PepVentura/Aut-mata-Halloween-/README.md

# Autómata de Halloween 🎃

Caja con tres figuras de Halloween (fantasma, momia y parca de una guirnalda LED) que bailan cuando alguien pasa por delante. Un motor paso a paso mueve un eje con tres excéntricas desfasadas 120°: cada figura sube, baja y cabecea a su ritmo.

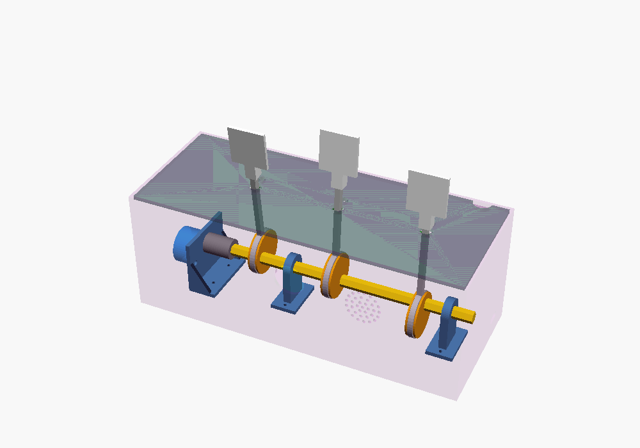
[picture p1: docs/montaje.png]
Montaje


## Cómo funciona

- **Motor:** 28BYJ-48 (5 V) con driver ULN2003, a unos 10 rpm.
- **Mecanismo:** eje hexagonal de 8 mm con tres excéntricas iguales (discos descentrados 8 mm); al montarlas se giran dos caras del hexágono (120°) entre sí. Cada biela abraza su excéntrica con un collar, pivota en un agujero de la tapa y lleva arriba una paleta donde se pega la figura. Como el eje queda dentro de la excéntrica, el mecanismo da vueltas completas en los dos sentidos sin que la biela toque el eje.
- **Disparo:** sensor PIR HC-SR501 en la pared frontal. Al detectar a alguien, las figuras bailan 20 s con tramos aleatorios y algún cambio de sentido.
- **Control:** Arduino (Nano/Uno).
- **Sonido:** módulo grabador de voz con un efecto grabado que suena al empezar cada baile, por un altavoz de 8 Ω 2 W tras una rejilla en la pared frontal.
- **Alimentación:** 5 V por un conector USB-C de panel en el lateral.

## Estructura

| Carpeta | Contenido |
|---|---|
| `cad/` | Diseño paramétrico en OpenSCAD (`MODO` elige montaje, piezas, caja, tapa…) |
| `stl/` | Piezas exportadas listas para laminar |
| `firmware/` | Sketch definitivo (`automata_halloween`) y sketch de prueba de componentes (`prueba_componentes`) |
| `docs/` | Manuales, esquema de conexiones, vistas del montaje y plantilla 2D de la tapa |

## Piezas a imprimir

| STL | Cantidad | Notas |
|---|---|---|
| `eje.stl` | 1 | 200 mm, tumbado sobre una cara plana |
| `excentrica.stl` | 3 | Reborde contra la cama |
| `arandela.stl` | 3 | Plana (segundo reborde de cada excéntrica) |
| `biela.stl` | 3 | Plana (collar + brazo) |
| `paleta.stl` | 3 | Cara de pegar la figura contra la cama |
| `acople.stl` | 1 | De pie |
| `soporte.stl` | 2 | De pie, sin soportes |
| `soporte_motor.stl` | 1 | De pie, sin soportes |
| `caja.stl` | 1 | Boca arriba, 251 × 101 × 95 mm (cabe en la Kobra X) |
| `tapa.stl` | 1 | Plana |

## Material

- Motor 28BYJ-48 + placa ULN2003
- Sensor PIR HC-SR501
- Arduino Nano o Uno
- Conector USB-C de panel con cables
- Módulo grabador de voz (30/120 s), altavoz 8 Ω 2 W (30 mm) y un diodo 1N4007 o 1N4148
- Tornillería: 2 × M3/M4 (motor), 6 × M2 x 6 avellanados de rosca chapa (arandela a excéntrica), 6 × M3x8 avellanados de rosca chapa (soportes desde debajo de la caja), 2 × M2 de rosca chapa (PIR), 10 × rosca chapa M3/2,9 x 10 y 2 × M2 x 8 de rosca chapa (placas electrónicas)
- Transistor NPN (2N2222/BC547), resistencias de 1 kΩ y 10–22 Ω, condensador 470 µF / 10 V y placa perforada para el reparto de 5 V/GND
- Las figuras se alimentan del pin 3,3 V del Uno (consumo < 100 mA, sin pilas)

## Conexiones

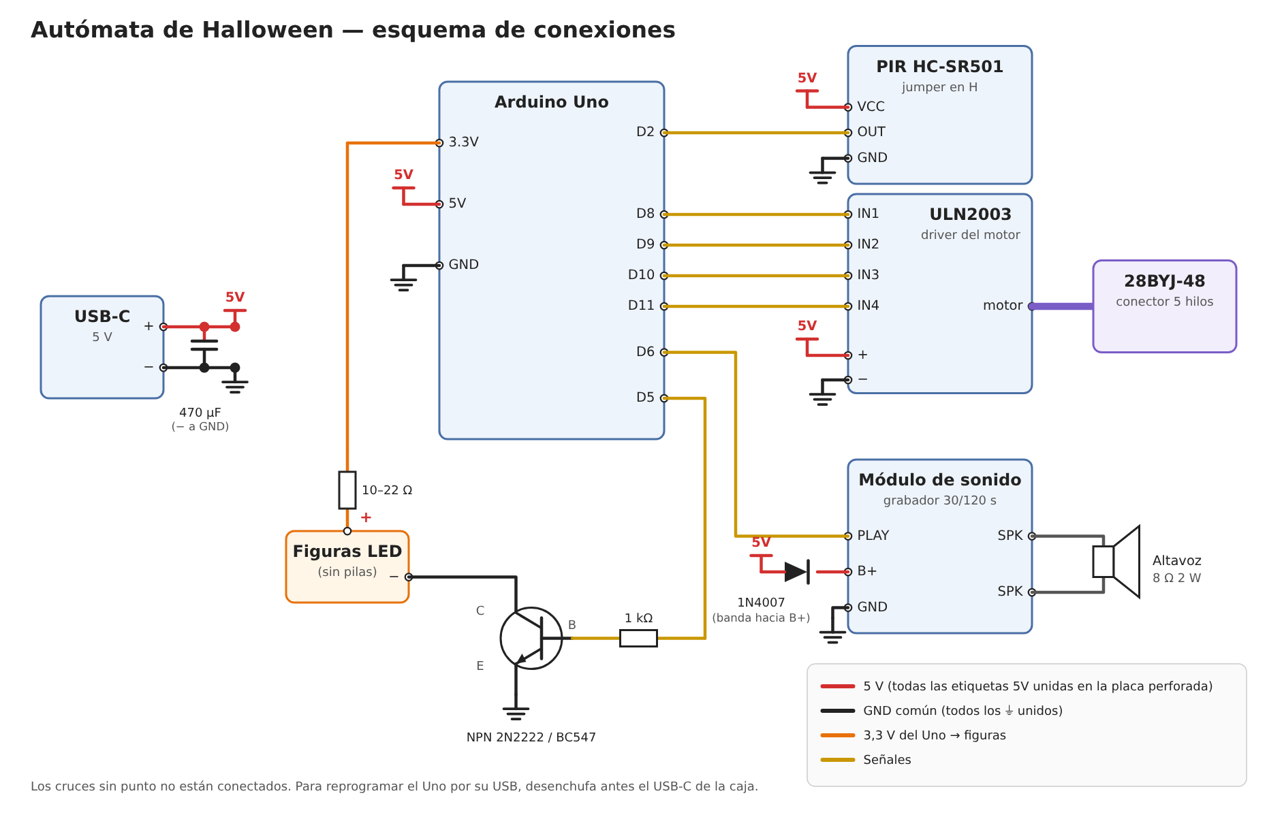
[picture p2: docs/esquema.png]
Esquema de conexiones


Manuales: **[Arduino Uno](docs/manual_arduino.md)** (pines, alimentación, programación, pruebas por partes, configuración y problemas) y **[módulo de sonido](docs/manual_modulo_sonido.md)**.

| Componente | Pin | Arduino |
|---|---|---|
| HC-SR501 | VCC / GND / OUT | 5V / GND / D2 |
| ULN2003 | IN1–IN4 | D8–D11 |
| ULN2003 | + / − | 5 V y GND del USB-C |
| Módulo de sonido | B+ / GND | 5V **a través de un diodo** (~4,3 V) / GND |
| Módulo de sonido | PE (reproducción por pulso) | D6 |
| Módulo de sonido | SPK | Altavoz 8 Ω |
| Figuras LED | Base del NPN vía 1 kΩ | D5 |
| Figuras LED | + (vía 10–22 Ω) / − al colector del NPN | 3.3V / emisor del NPN a GND |
| Uno | 5V / GND | 5 V y GND del USB-C (no usar VIN ni el jack) |
| Condensador 470 µF | + / − | 5 V / GND, junto a la entrada USB-C |

Ajustes del HC-SR501: jumper en **H** (redisparo) y potenciómetro de tiempo al mínimo; la duración del baile la decide el código. Al encender, el PIR necesita ~1 minuto para estabilizarse.

## Avisos

- **USB-C:** muchos conectores de dos cables no llevan las resistencias de 5,1 kΩ en CC. Sin ellas, un cargador USB-C a USB-C no da corriente; usa un cable USB-A a USB-C.
- **Hueco del USB-C:** hecho para el cuerpo del conector (12 × 5 mm medidos, con 0,4 mm de holgura): el cuerpo atraviesa la pared desde fuera, el frontal más ancho hace de tope y las pestañas enganchan por dentro en la pared rebajada. Antes de la caja imprime `stl/prueba_usb.stl` (un trozo de pared de 2 minutos) y, si no encaja, ajusta `usb_w`, `usb_h` y `usb_pared`.
- **Altavoz:** de 30 mm (`alt_d`). Se coloca con el cono hacia la rejilla dentro del aro y se fija con unos puntos de termocola.
- **Placas electrónicas:** van de pie en la pared trasera sobre columnas de 6 mm (el Uno no cabe tumbado). Las medidas del Uno son las oficiales; las del ULN2003 (agujeros a 27 × 30 mm) y el módulo de sonido (placa 28 × 30, agujeros a 25 × 5 mm: el izquierdo abajo y el derecho 5 mm más alto, tornillos M2) están medidas; la placa del transistor es provisional: mide la posición de sus agujeros y ajusta la lista `placas` antes de imprimir la caja.
- **Lente del PIR:** ajusta `pir_sep` según el grosor de la base de la lente.
- **Motor parado:** el sketch apaga las bobinas al terminar cada baile para que no se caliente.

## Grabar el sonido

Consulta el **[manual del módulo de sonido](docs/manual_modulo_sonido.md)**: identificación de pads, conexionado, configuración, cómo grabar (con micrófono o por cable) y solución de problemas. En resumen: graba unos 20 s para que coincida con `DURACION_BAILE` y conecta D6 al pad **PE** (reproducción por pulso).

## Montaje

1. Atornilla el soporte del motor y los dos soportes del eje desde debajo de la caja.
2. Fija el motor al soporte y encaja el acople en su eje.
3. Mete el eje hexagonal por los soportes. Para cada figura, ensarta en este orden: excéntrica (reborde hacia el motor), biela con el collar alrededor del disco y arandela, con el mismo contorno que la excéntrica y el avellanado hacia fuera. Atornilla la arandela a la excéntrica con dos M2 x 6. Cada excéntrica va girada dos caras del hexágono (120°) respecto a la anterior. Cuando las bielas estén alineadas con los agujeros de la tapa, fija cada excéntrica al eje con una gota de cianoacrilato para que no se desplace. Un poco de vaselina o grasa de silicona en el disco reduce el ruido.
4. Comprueba girando el eje a mano que da vueltas completas sin enganches.
5. Pasa las bielas por los agujeros de la tapa, encaja las paletas y pega las figuras por detrás.
6. Baja los cables de la guirnalda por los agujeros pequeños, dejando un bucle flojo dentro.
7. Pega el altavoz en su aro de la pared frontal.
8. Atornilla el Arduino, el ULN2003, el módulo de sonido y la placa del transistor a sus columnas de la pared trasera, con los componentes hacia dentro. La pila de la guirnalda va con cinta de doble cara en el suelo, detrás del mecanismo.

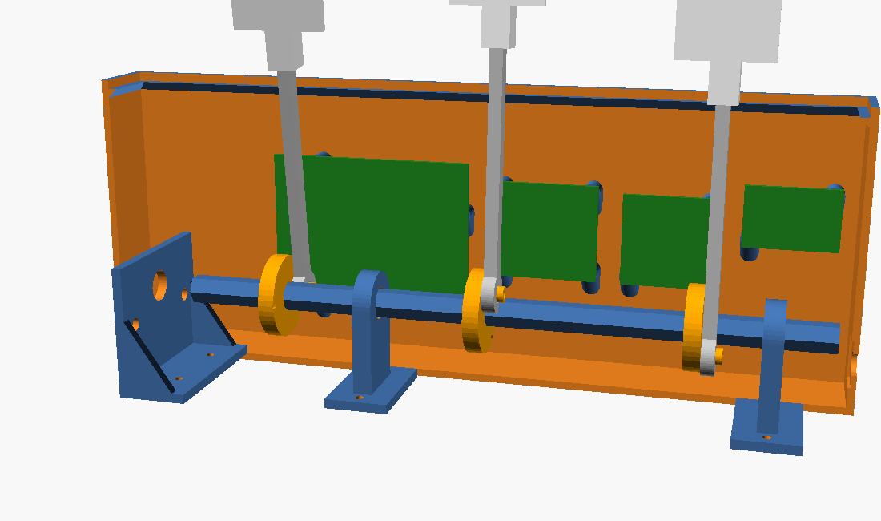
[picture p3: docs/interior.png]
Interior
