PepVentura/Aut-mata-Halloween-/docs/caja.png

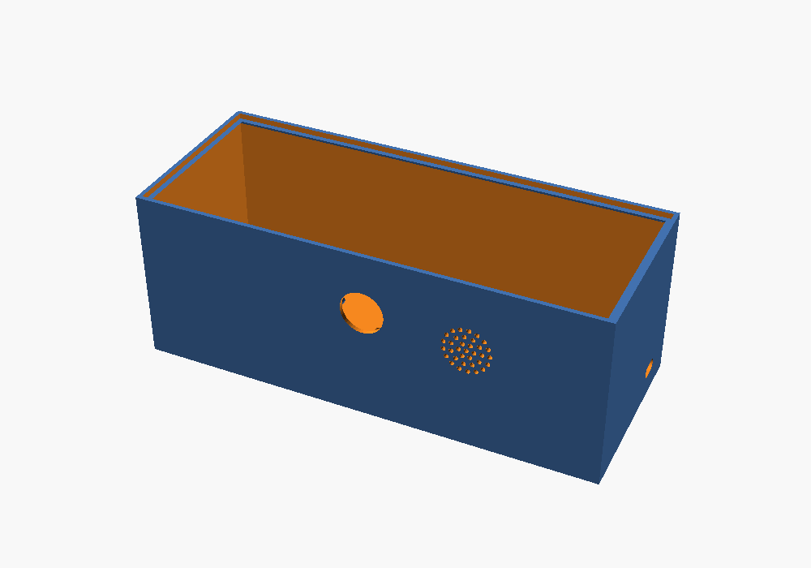
docs/caja.png
