PepVentura/Aut-mata-Halloween-/docs/frente.png

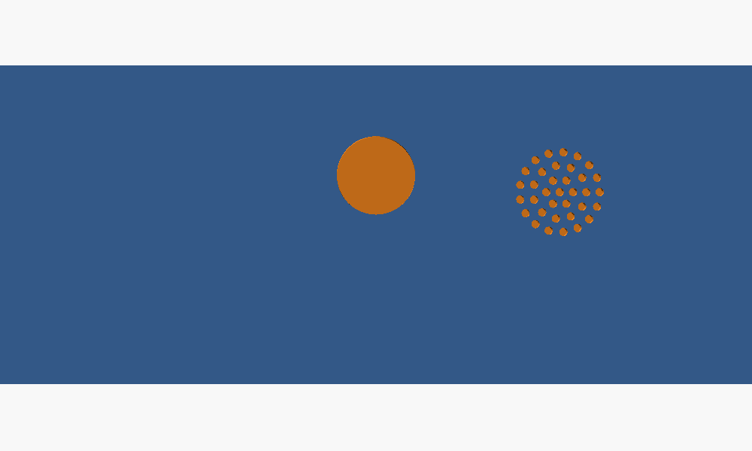
docs/frente.png
