PepVentura/Aut-mata-Halloween-/docs/imprimir.png

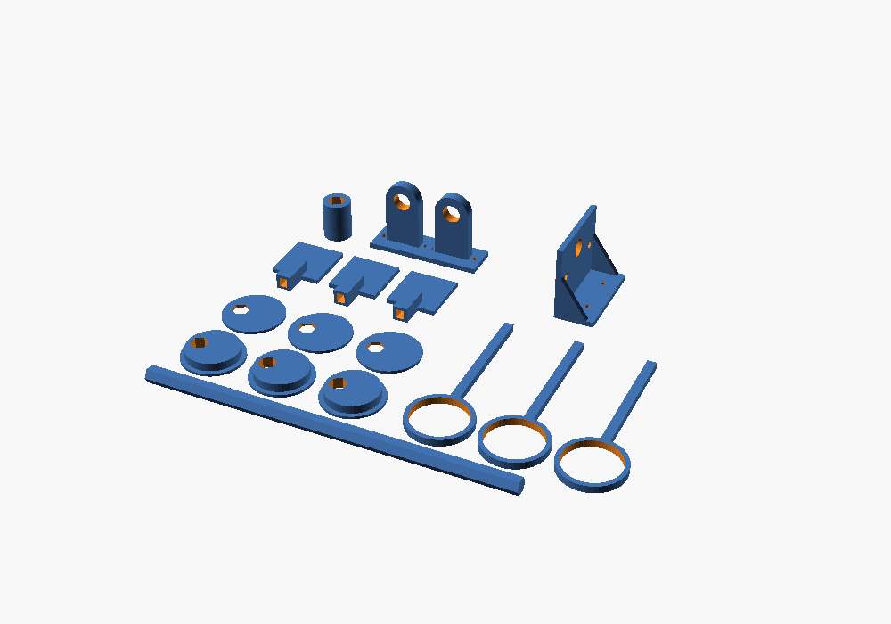
docs/imprimir.png
