PepVentura/Aut-mata-Halloween-/stl/arandela.stl

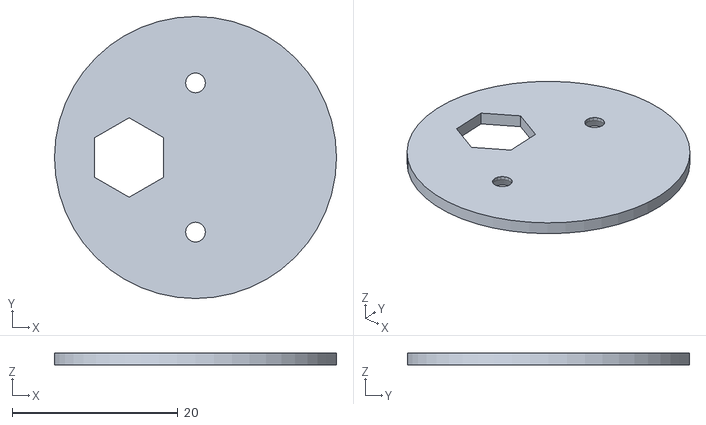
[picture p7: CAD file, 2026-10-29]
stl/arandela.stl
34.0 x 34.0 x 1.50
