PepVentura/Aut-mata-Halloween-/stl/excentrica.stl

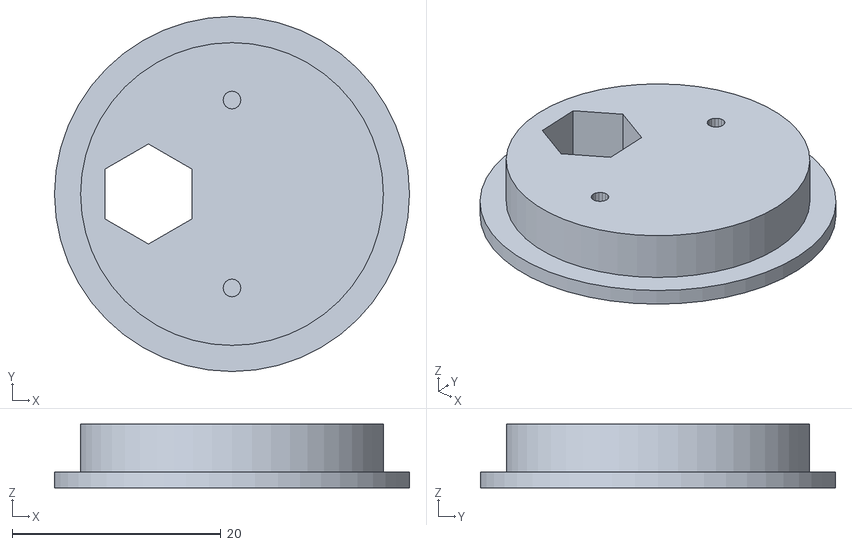
[picture p8: CAD file, 2026-10-29]
stl/excentrica.stl
34.0 x 34.0 x 6.10
