PepVentura/Aut-mata-Halloween-/stl/tapa.stl

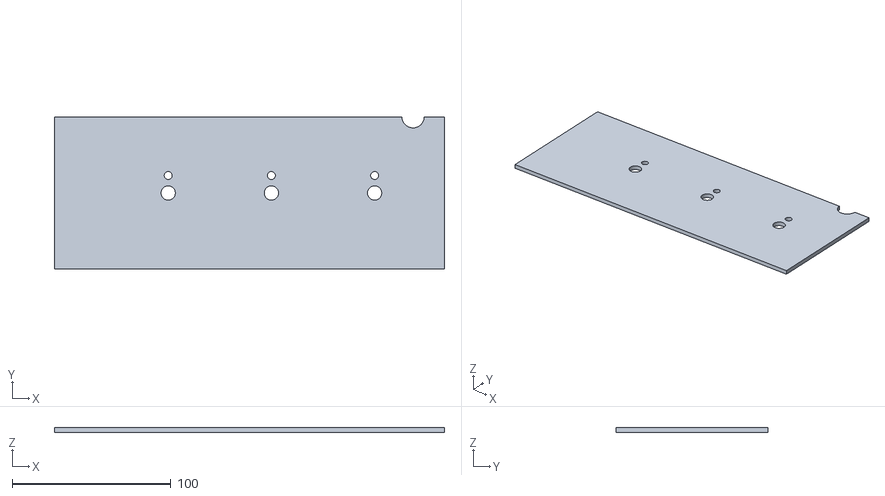
[picture p9: CAD file, 2026-10-28]
stl/tapa.stl
245.6 x 95.6 x 3.00
