PepVentura/Aut-mata-Halloween-/stl/biela.stl

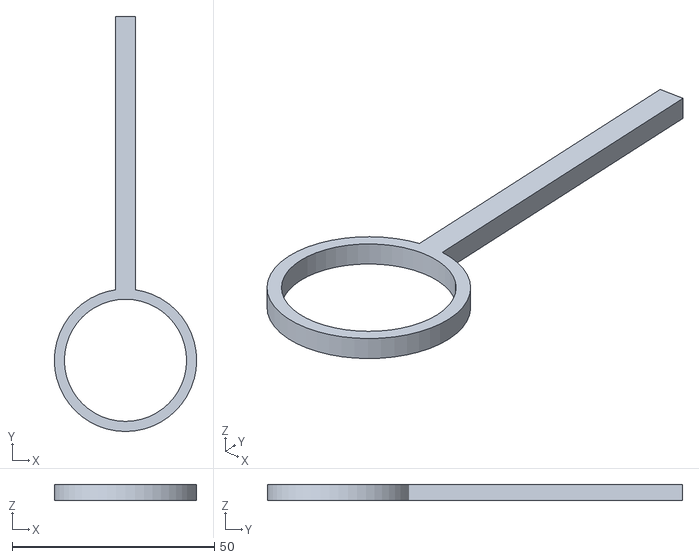
[picture p10: CAD file, 2026-10-28]
stl/biela.stl
35.2 x 102.6 x 4.00
