PepVentura/Aut-mata-Halloween-/stl/caja.stl

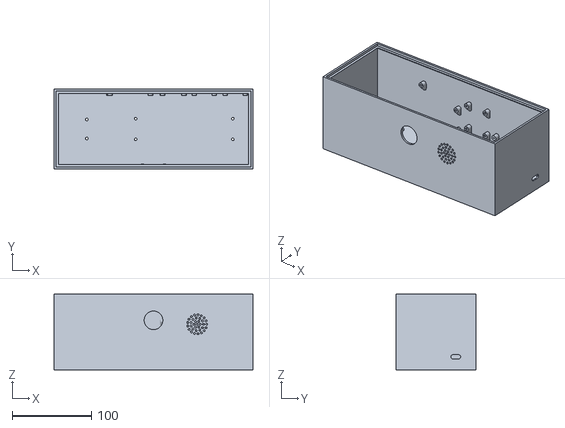
[picture p11: CAD file, 2026-10-27]
stl/caja.stl
250.8 x 100.8 x 95.4
