PepVentura/Aut-mata-Halloween-/stl/prueba_usb.stl

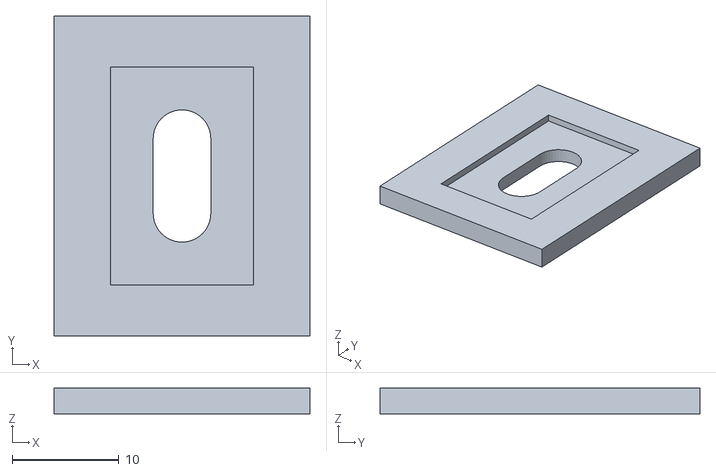
[picture p12: CAD file, 2026-10-27]
stl/prueba_usb.stl
24.0 x 30.0 x 2.40
