PepVentura/Aut-mata-Halloween-/stl/acople.stl

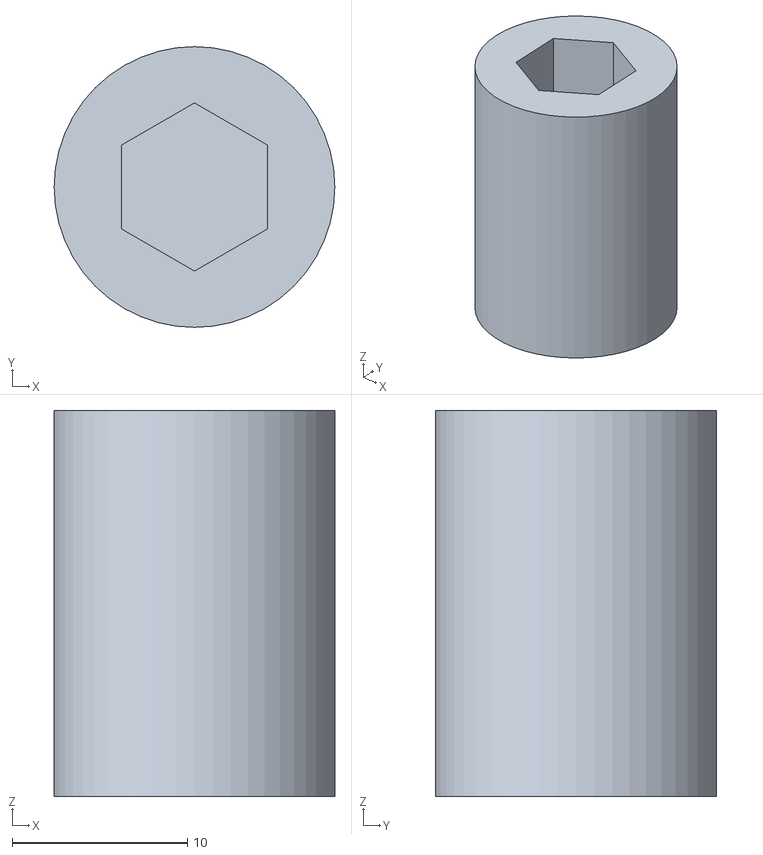
[picture p13: CAD file, 2026-10-26]
stl/acople.stl
16.0 x 16.0 x 22.0
