PepVentura/Aut-mata-Halloween-/stl/soporte_motor.stl

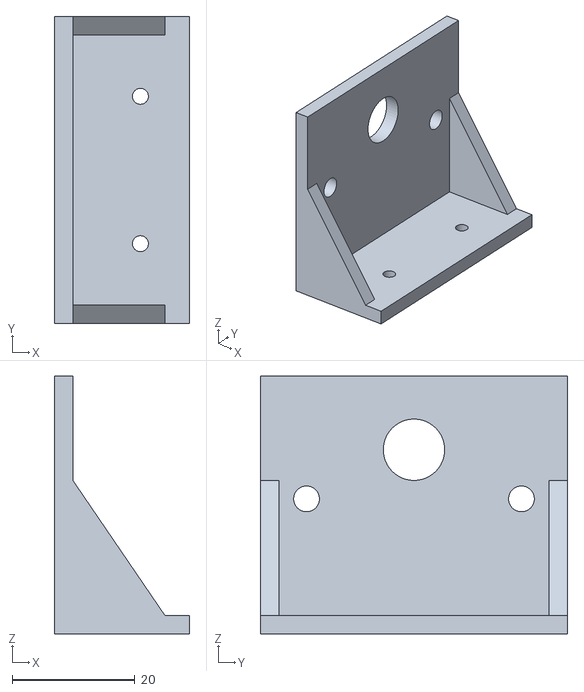
[picture p14: CAD file, 2026-10-26]
stl/soporte_motor.stl
22.0 x 50.0 x 42.0
