PepVentura/Aut-mata-Halloween-/stl/eje.stl

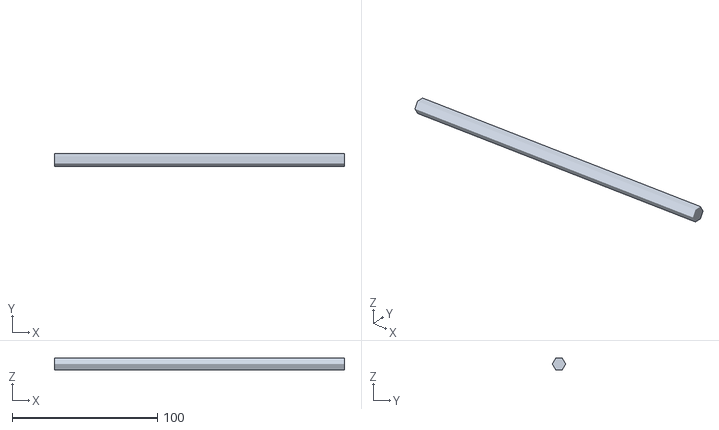
[picture p15: CAD file, 2026-10-26]
stl/eje.stl
200.0 x 9.24 x 8.00
