PepVentura/Aut-mata-Halloween-/stl/paleta.stl

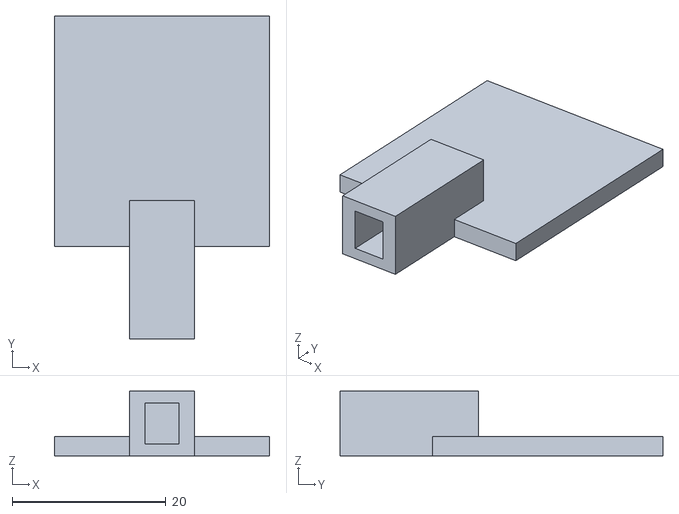
[picture p16: CAD file, 2026-10-26]
stl/paleta.stl
28.0 x 42.0 x 8.40
