PepVentura/Aut-mata-Halloween-/stl/soporte.stl

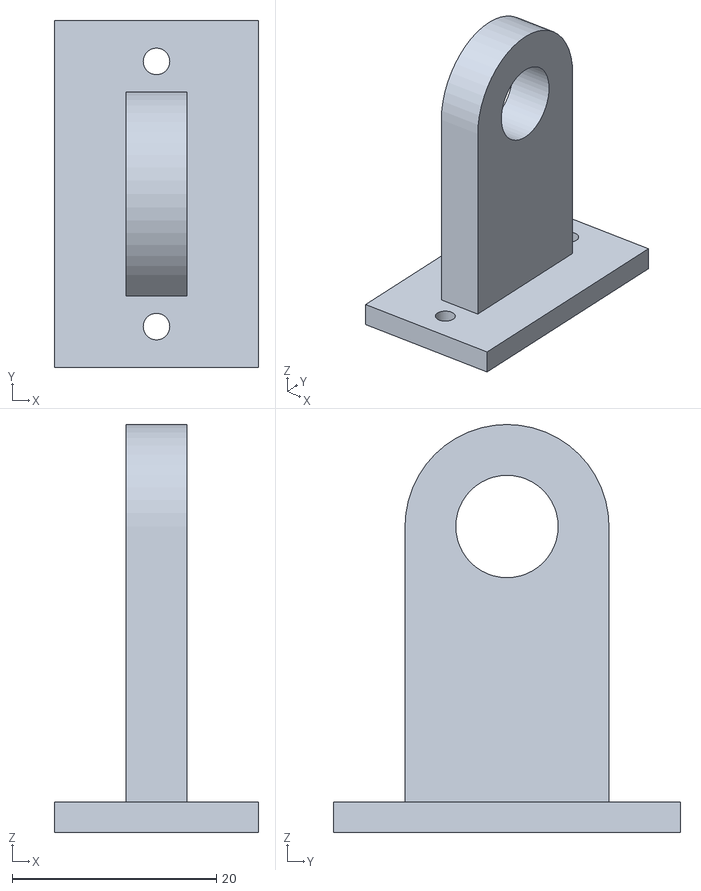
[picture p17: CAD file, 2026-10-26]
stl/soporte.stl
20.0 x 34.0 x 40.0
