PepVentura/Aut-mata-Halloween-/(commit log)

2026-10-26 Autómata de Halloween: diseño, STL y firmware
    Diseño paramétrico en OpenSCAD (cigüeñal hexagonal, manivelas, bielas,
    paletas, soportes, caja con PIR y USB-C, tapa), piezas exportadas a STL,
    sketch de Arduino para 28BYJ-48 + ULN2003 + HC-SR501 y documentación.
    Claude-Session: https://claude.ai/code/session_01QANvDE4aNo52X5TNoB4PQy
    [acople.stl, automata_halloween.scad, biela.stl, caja.stl, eje.stl, manivela.stl, paleta.stl, soporte.stl]
2026-10-27 Añade sonido: módulo grabador de voz y altavoz
    - Rejilla y aro para altavoz de 8 ohm 2 W en la pared frontal (alt_d paramétrico)
    - Sketch: dispara el módulo por D6 al empezar cada baile (pulso a GND sin meter 5 V)
    - README: material, conexiones con diodo de caída y cómo grabar el efecto
    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
    [automata_halloween.scad, caja.stl]
2026-10-27 Altavoz medido: 30 mm de diámetro
    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
    [automata_halloween.scad, caja.stl]
2026-10-27 Columnas en la pared trasera para Arduino Uno, ULN2003, módulo de sonido y placa del transistor
    Medidas del Uno oficiales; el resto, provisionales hasta medirlas.
    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
    [automata_halloween.scad, caja.stl]
2026-10-27 ULN2003 medido: agujeros a 27 x 30 mm
    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
    [automata_halloween.scad, caja.stl]
2026-10-27 Módulo de sonido medido: placa 28 x 30, agujeros a 25 x 5 mm
    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
    [automata_halloween.scad, caja.stl]
2026-10-27 Módulo de sonido: posición real de los agujeros y piloto para M2
    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
    [automata_halloween.scad, caja.stl]
2026-10-27 USB-C medido (12 x 5 mm) y pieza de prueba del hueco
    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
    [automata_halloween.scad, caja.stl, prueba_usb.stl]
2026-10-27 USB-C: la medida es del cuerpo que atraviesa la pared (aclarado)
    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
    [automata_halloween.scad]
2026-10-28 Excéntricas en lugar de manivelas: giro completo sin choque
    Con el eje pasante, el anillo de la biela y su brazo chocaban con el eje
    (el pasador estaba a 8 mm del centro y el eje ocupa 4,6 mm de radio).
    Ahora cada biela abraza un disco descentrado que contiene el eje, con
    dos rebordes (excéntrica + arandela). Comprobado sin interferencias en
    una vuelta completa contra eje, excéntricas y suelo.
    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
    [arandela.stl, automata_halloween.scad, biela.stl, excentrica.stl, manivela.stl, tapa.stl]
2026-10-29 Arandela atornillada a la excéntrica con 2 tornillos M2 x 6
    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
    [arandela.stl, automata_halloween.scad, excentrica.stl]
2026-10-29 Esquema de conexiones y alimentación de figuras y Arduino
    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
2026-10-30 Manual del módulo de sonido en castellano
    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
2026-10-30 Manual del Arduino Uno y sketch de prueba de componentes
    - docs/manual_arduino.md: pines, alimentación, IDE, pruebas, configuración y problemas
    - firmware/prueba_componentes: menú por monitor serie para probar motor, PIR, sonido y luces
    - Cabecera del sketch principal actualizada (excéntricas, PE, figuras a 3,3 V, A0 libre)
    - Ambos sketches compilados para ATmega328P sin avisos
    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
    [automata_halloween.ino, prueba_componentes.ino]
2026-10-30 Manual Arduino: pinout oficial anotado con las conexiones del autómata
    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
